SashLi/FreeVarioGauge/Bill_of_Material.xlsx

Sheet: Vario
Value | Part | Part Count | Vendor | Vendor P/N
Vario Board 1
NHD-2.4-240320CF-CSXN#-F |  | 1 | https://www.luna-electronic.de/de/tft-displays/newhaven-display-nhd-2-4-240320cf-csxn-f-2-4-sunlight-readable-tft.html
Espressif ESP32 WLAN Dev Kit Board Development Bluetooth Wifi v1 | US1 | 1 | https://www.ebay.de/itm/Espressif-ESP32-WLAN-Dev-Kit-Board-Development-Bluetooth-Wifi-v1-Deutsche-Post/163771189294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
Precision sockets 2,54 mm, 1X15 |  | 2 | Reichelt | MPE 115-1-015
Pinheader female, 8-pin | SV2 | 1 | Reichelt | RND 205-00653
Pinheader female, 4-pin | JP1 | 1 | Reichelt | RND 205-00651
RJ45 | X1 | 1 | Ebay, Mouser | 215877-1
595-MAX3232-CDWR or 595-MAX3232-IDWR | IC1 | 1 | Reichelt | MAX 3232 CWE
EA WF050-40ST ZIFF conector | X2 | 1 | Reichelt | EA WF050-40ST
SMD chip resistor, 0805, 100 Ohm | R1, R2 | 2 | Reichelt | RND 0805 1 100
SMD chip resistor, 0805, 68 kOhm | R3 | 1 | Reichelt | RND 0805 1 68K
SMD chip resistor, 0805, 33 kOhm | R4 | 1 | Reichelt | RND 0805 1 33K
SMD chip resistor, 0805, 820 Ohm | R5 | 1 | Reichelt | RND 0805 1 820
SMD chip resistor, 0805, 470 Ohm | R6 | 1 | Reichelt | RND 0805 1 470
SMD chip resistor, 0805, 330 Ohm | R7 | 1 | Reichelt | RND 0805 1 330
SMD multilayer ceramic capacitor 10N | C4 | 1 | Reichelt | X7R-G0805 10N
SMD multilayer ceramic capacitor 100N | C1, C2, C3, C5, C8 | 5 | Reichelt | X7R-G0805 100N
SMD multilayer capacitor G0805 - 1,0µF 50V | C9, C11, C14, C17 | 4 | Reichelt | X7R-G0805 1,0/50
SMD multilayer capacitor G0805 - 10µF 16V | C6, C7, C10, C12, C13 | 5 | Reichelt | X5R-G0805 10/16
SMD multilayer ceramic capacitor 220P, 5% | C15, C16 | 2 | Reichelt | NPO-G0805 220P
multilayer ceramic capacitor, 4,7µF, 25V | C18 | 1 | Reichelt | KEM X5R0805 4,7U
transistor, NPN | T1 | 1 | Reichelt | BC 848C SMD
EMI Suppression Filter SMD0603 BLM18 120 Ohm | L1, L2 | 2 | Reichelt | BLM18AG 121
PAM8302A | IC2 | 1
NCP 1117 ST50T3G | Q1 | 1 | Reichelt | NCP 1117 ST50T3G
NCP 1117 ST33T3G | Q2 | 1 | Reichelt | NCP 1117 ST33T3G
Heat sink SMD 6,3 x4,8x 5,0mm | Q1, Q2 | 2 | Reichelt | ICK SMD A5
Self-adhesive thermal foil | Q1, Q2 | 1 | https://www.ebay.de/itm/EC360-ADHESIVE-WHITE-Wärmeleitfolie-kleber-50x50mm-Doppelseitig-3W-mK-WLPad/113931974912?ssPageName=STRK%3AMEBIDX%3AIT
PCB
Vario Board 2
Espressif ESP32 WLAN Dev Kit Board Development Bluetooth Wifi v1 | US1 | 1 | https://www.ebay.de/itm/Espressif-ESP32-WLAN-Dev-Kit-Board-Development-Bluetooth-Wifi-v1-Deutsche-Post/163771189294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
SMD chip resistor, 0805, 10 kOhm | R1, R2, R3, R4, R5 | 5 | Reichelt | SMD-0805 10,0K
TS 4148-1206 Switching diode, 75 V, 150 mA, G1206 | D1 | 1 | Reichelt | TS 4148-1206
SMD multilayer ceramic capacitor 100N | C1 | 1 | Reichelt | X7R-G0805 100N
Pin headers 2.54 mm, 2X05, angled | JP3 | 1 | Reichelt | MPE 088-2-010
Stack bar 2x4 h=26,5mm | X3 | 1
Stack bar 2x2 h=26,5mm | JP1 | 1
Slide switch 1x UM, upright | X4 | 1 | Reichelt | SS ESP101
Precision sockets 2,54 mm, 1x7 | JP2 | 1 | Reichelt | MPE 115-1-007
Precision sockets 2,54 mm, 1X15 | US1 | 2 | Reichelt | MPE 115-1-015
2-pin header, angled | Speaker | 1 | Reichelt | SL 1X36W 2,54
Speaker LSM-S30K/P, 2W, 8Ohm | Speaker | 1 | Reichelt | LSM-S30K/P
JST - socket housing, 1x3-pin - XH | STF-WOELBKLAPPEN | 1 | Reichelt | JST XH3P BU
JST - Stiftleiste, 90°, 1x3-polig - XH | STF-WOELBKLAPPEN | 1 | Reichelt | JST XH3P ST90
JST - crimp contact, socket - XH | STF-WOELBKLAPPEN | 2 | Reichelt | JST XH CKB
PJ-242 - audio jack 2,5mm | X1 | 1 | Aliexpress
PCB
Vario Encoder Board
Potentiometer, 25 kOhm bzw. 22kOhm | R1 | 1 | Reichelt | PIH T16SHM4N253B oder PO4M-LOG 22K
Pinheader female, 10-pin | X1 | 1 | Reichelt | RND 205-00654
JST - socket housing, 1x3-pin - XH | X2 | 1 | Reichelt | JST XH3P BU
JST - pin header, straight, 1x3-pin - XH | X2 | 1 | Reichelt | JST XH3P ST
JST - crimp contact, socket - XH | X2 | 3 | Reichelt | JST XH CKB
Toggle switch 6A-125VAC, 1x On-Off-ON |  | 1 | Reichelt | MS 500C
Encoder | SW1 | 1 |  | PEC11R-4230F-S0012
Banjo bolts (wie z.B. beim Funke ATR833) |  | 2
ROUND KNOB 10, WITHOUT LINE, 4mm Bore hole |  | 2 | https://www.okw.com/ | A2510040 (https://www.okw.com/de/Kombikn%C3%B6pfe/A2510030.htm?var=af9c94b0-c2e5-11e2-8e2c-0050568225d7)
COVER 10, WITHOUT LINE |  | 2 | https://www.okw.com/ | A4110000 (https://www.okw.com/de/Kombikn%C3%B6pfe-Zubeh%C3%B6r/A4110000.htm)
PCB |  | 1

Sheet: BOM-PCB1
Comment | Designator | Footprint | LCSC Part #（optional）
MAX 3232 CWE | IC1 | SO-16 | C143432 (https://lcsc.com/product-detail/RS232-ICs_Maxim-Integrated_MAX3232ECWE_Maxim-Integrated-MAX3232ECWE_C143432.html)
MOLEX 541044031 | X2 | ZIF SMD | C164172 (https://lcsc.com/product-detail/FFC-FPC-Connectors_MOLEX_541044031_MOLEX-541044031_C164172.html)
SMD-Widerstand, 0805, 10 kOhm | R1, R2 | 0805 | C84376
10nF | C4 | 0805 | C83170 (https://lcsc.com/product-detail/Multilayer-Ceramic-Capacitors-MLCC-SMD-SMT_10nF-103-10-50V_C83170.html)
100nF | C1, C2, C3, C5, C8 | 0805 | C49678
1µF | C9, C11, C14 | 0805 | C77083 (https://lcsc.com/product-detail/Multilayer-Ceramic-Capacitors-MLCC-SMD-SMT_muRata_GRM21BR71H105KA12L_1uF-105-10-50V_C77083.html)
10µF | C6, C7, C10, C12, C13 | 0805 | C77075
PAM8302AASCR (https://lcsc.com/product-detail/Audio-Power-OpAmps_Diodes-Incorporated_PAM8302AASCR_Diodes-Incorporated-PAM8302AASCR_C113367.html) | IC2 | MSOP8 | C113367 (https://lcsc.com/product-detail/Audio-Power-OpAmps_Diodes-Incorporated_PAM8302AASCR_Diodes-Incorporated-PAM8302AASCR_C113367.html)
NCP 1117 ST50T3G | Q1 | SOT-223 | C17314 (https://lcsc.com/product-detail/Low-Dropout-Regulators-LDO_ON-Semiconductor-ON-NCP1117ST50T3G_C17314.html)
NCP 1117 ST33T3G | Q2 | SOT-223 | C26537

Sheet: BOM-PCB2
Comment | Designator | Footprint | LCSC Part #（optional）
SMD-Widerstand, 0805, 10 kOhm | R1, R2, R3, R4 | 0805 | C84376
100nF | C1 | 0805 | C49678

Sheet: BOM-PCB3
Comment | Designator | Footprint | LCSC Part #（optional）
SMD-Widerstand, 0805, 10 kOhm | R1, R2, R3, R4 | 0805 | C84376
100nF | C1 | 0805 | C49678
