SashLi/FreeVarioGauge/Housing/body_housing.stl

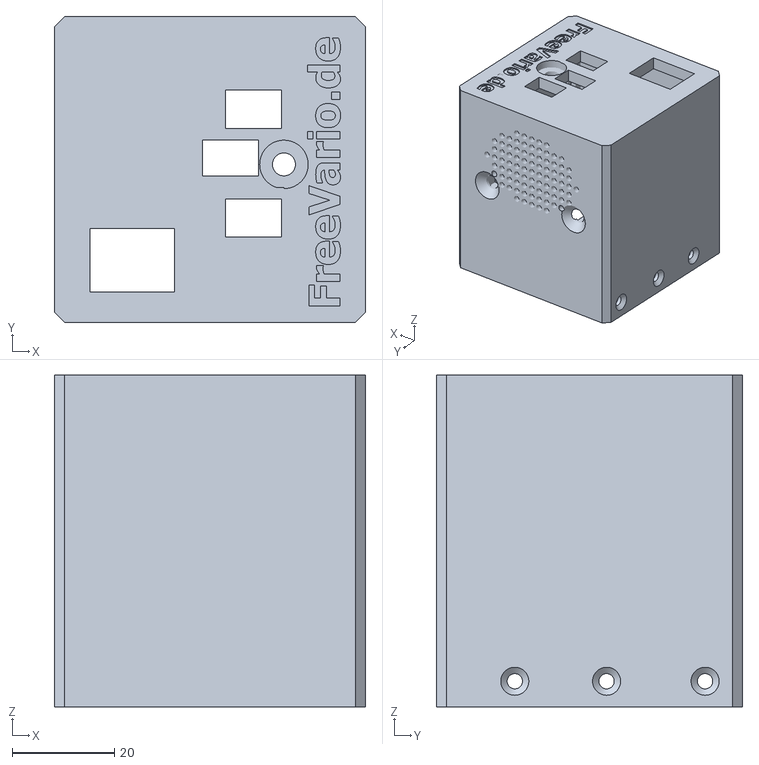
[picture p1: CAD file, 2020-09-28]
Housing/body_housing.stl
61.0 x 60.0 x 65.0
