SashLi/FreeVarioGauge/Housing/MicroUSB.stl

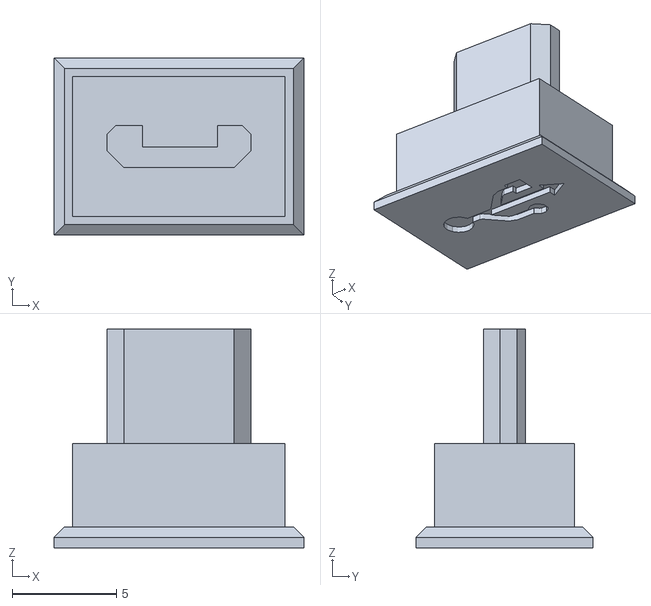
[picture p2: CAD file, 2020-07-25]
Housing/MicroUSB.stl
12.0 x 8.50 x 10.5
