SashLi/FreeVarioGauge/manuals/Instruction_DE.pdf

Copyright Dirk Jung | licensed under CC BY-SA | Page 1

## Anleitung zum Bau und zum Bedienen des FreeVarios

## Inhaltsverzeichnis

V. Installieren von XCSoar inkl. FreeVario-Treiber ohne Neuinstallation des OV-

Ich arbeite auf einem Mac bzw. Linuxsystem. Auf einem Windowsrechner können Kleinigkeiten abweichen!

I. Allgemeines

Das FreeVario wird mit 12V betrieben. Wenn es z.B. mit dem Micro-USB-Stecker nur an 5V angeschlossen wird, funktioniert es grundsätzlich, aber der Audio-Verstärker arbeitet dann nicht fehlerfrei. Er macht dann Geräusche. Das ist also kein Fehler, sondern liegt an der falschen Spannung.
Die Maßgenauigkeit der 3D-gedruckten Teile hängt extrem von den Einstellungen eures Druckers und vom Material ab. Es kann also vorkommen, dass die Teile zu klein sind. Dann müsst ihr die Teile um wenige Prozent größer drucken.
Es scheint hin und wieder unterschiedliche Platinengrößen des ESP32 zu geben. Die Folge ist, dass das Gehäuse nicht richtig schließt. Aus diesem Grunde schneide ich nun immer eine Ecke der Platine ab.


II. Bestücken der Platinen und Zusammenbau des e-Varios

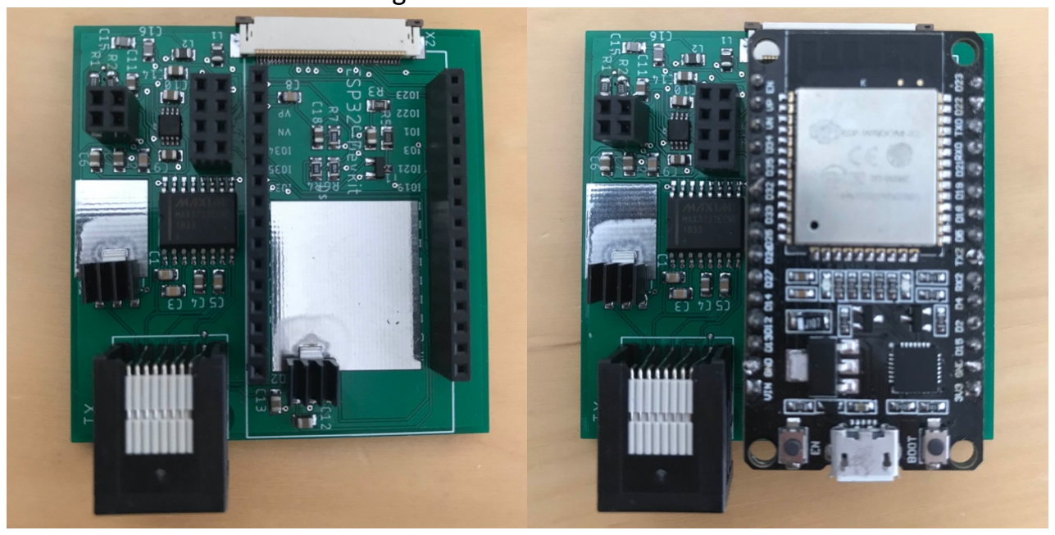
[picture p13: figure]

1. PCB1 sowie auf den Bildern dargestellt zusammenlöten.


2. PCB2 sowie auf den Bildern dargestellt zusammenlöten. Der Abstand der beiden Kunststoffhalterungen der Stapelleiste muss auf 8mm eingestellt werden. Die zu langen Stifte mit einem Seitenschneider auf 22 mm kürzen (siehe 3. Bild).
Mit Hilfe des Schiebeschalters stellt ihr ein, wie das Vario später im Automatikmodus arbeitet. Stellt ihr es auf XCSoar, schickt XCSoar Befehle um zwischen STF und Vario zu wechseln. Stellt ihr es auf Flaps, wird im Automatikmodus durch einen an dem weißen, dreipoligen Stecker angeschlossenen Schalter zwischen STF und Vario umgeschaltet. Dieser Schalter kann z.B. an den Wölbklappen angebracht werden. Wenn das Vario auf STF gestellt werden soll, sollte dieser Schalter geschlossen sein.

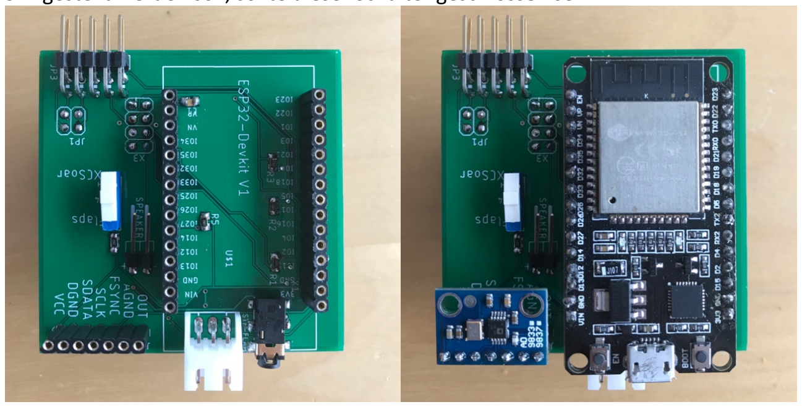
[picture p14: figure]


Die 2,5mm Klinkenbuchse dient zum Anschließen eines externen Lautsprechers. Wird der externe Lautsprecher angeschlossen, wird der interne automatisch abgeschaltet. Beim Löten der Klinkenbuchse müsst ihr sehr vorsichtig sein. Wird zu viel Lötzinn verwendet, funktioniert der Schalter in der Klinkenbuchse anschließend nicht richtig, weil das Lötzinn eindringt, und blockiert. Ich empfehle, die Buchse nach dem Löten wirklich mit und ohne Stecker durchzumessen und ggf. wieder abzulöten und es erneut zu versuchen.

3. Den Drehencoder vorsichtig zerlegen, indem ihr die kleinen Metallbügel aufbiegt. Die Achse des Drehencoders ist mit einem Sicherungsring gesichert. Ihr müsst mit einem Seitenschneider vorsichtig in den Spalt zw. Achse und Gehäuseoberteil gehen und leicht drücken. Wenn die Achse durch den Seitenschneider leicht beschädigt wird, die Stelle wegfeilen. Die Achsen in die Drehmaschine einspannen auf 4mm abdrehen. Anschließend den Drehencoder wieder sorgfältig zusammensetzen und die Metallbügel zurück biegen. Die Achse des Drehencoders wieder mit dem Ring sichern. Kauft euch den Drehencoder sicherheitshalber doppelt, beim ersten Mal geht es ggf. schief. Bohrt die Hohlschrauben auf 4,3mm auf.
4. Am PCB3 an der Position, wo der Encoder sitzt, müsst ihr auf der Seite mit den 3 PINs und oben noch den überstehenden Teil der Platine wegfeilen, sonst passt die Platine nicht spannungsfrei in das Gehäuse. Es kann durchaus sein, dass ihr hier nach dem Löten noch mal ein wenig feilen müsst. Die Kontakte des Potentiometers vorsichtig um 90° nach unten biegen und anlöten. Testet, ob nach der Montage der Frontplatte die Achsen des Encoders und des Potentiometers gut durch die Hohlschrauben passen und sich leicht betätigen lassen. Gegebenenfalls noch mal lösen und etwas verschieben. PCB3 sowie auf den Bildern dargestellt zusammenlöten. Achtet darauf, dass ihr den weißen Stecker so anlötet, dass die PINs auf der rechten Seite sind. Andernfalls passt die Platine später nicht in das Gehäuse. Die Achsen auf eine Länge von 34mm+Dicke des Instumentenbrettes kürzen, gemessen ab Platinenoberseite!

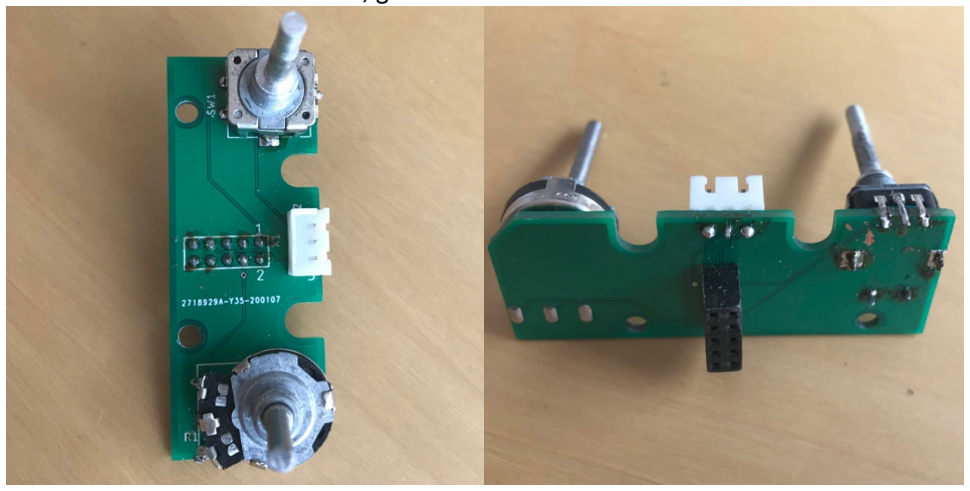
[picture p15: figure]

5. Die drei Gehäuseteile ausdrucken und die Gewinde, wie auf den Bildern markiert, in den Kunststoff schneiden. Rot=M3, Grün=M4, Blau=M6x0,75.
Ich habe sie mit PLA ausgedruckt.

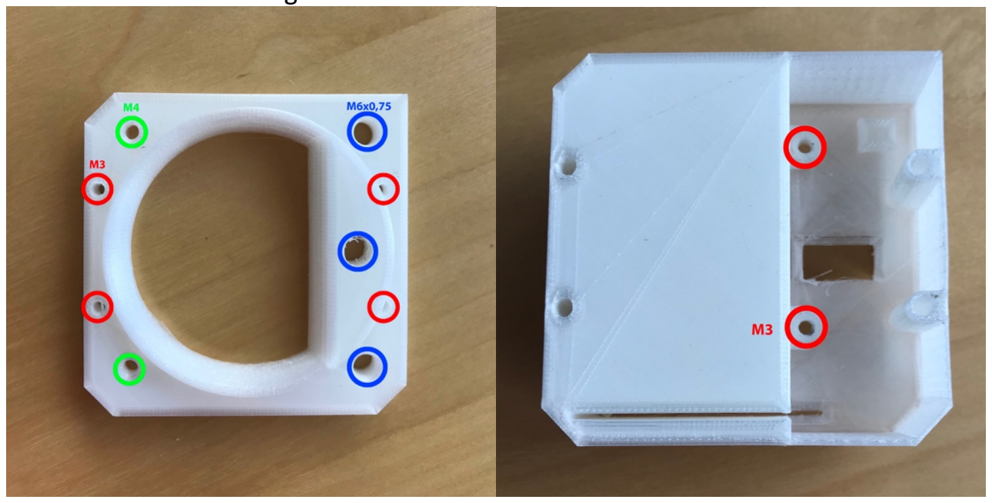
[picture p16: figure]


6. Zwei Gewinde M4 in den Lautsprecher schneiden und Lautsprecher mit 2 Senkkopfschrauben M4x8 im Gehäuse befestigen. Vorher etwa 10cm lange Kabel zum Anschließen des Lautsprechers anlöten. Der Lautsprecher ist nur erforderlich, wenn das FreeVario den Varioton ausgeben soll. Wollt Ihr weiterhin den Varioton von OpenVario nutzen, könnt ihr den Lautsprecher weglassen.
7. Stecker an ein etwa 5cm langes, 3-poliges Kabel krimpen und an den Kippschalter anlöten. Lötet so platzsparend wie möglich, in dem ihr schräg anlötet. Andernfalls gibt es später zwischen den Lötstellen und den dahinterliegenden Kontakten auf dem PCB3 einen Kurzschluss. Macht unbedingt Schrumpfschlauer die Lötkontakte!
Das mittlere Kabel kommt an die mittlere Lötfahne. Je nachdem wie ihr die beiden äußeren Kabel anlötet, habt ihr später STF oder Vario oben. Wenn ihr das obere Kabel des Steckers an die obere Lötfahne des Kippschalters, und das untere Kabel des Steckers an die untere Lötfahne des Kippschalters lötet, ist später Sollfahrt in der unteren Position des Kippschalters, und Vario in der oberen. Automatik ist in der Mitte.
8. Die Gewinde der beiden M4 Befestigungsschrauben auf 3mm + Instumentenbrettdicke kürzen. Arbeitet hier sehr genau, denn wenn die Schrauben zu lang sind, drücken Sie später auf das Display und zerstören es. Am besten ihr schraubt die Frontblende alleine einmal in das Cockpit und checkt, dass die Schrauben nicht in den Bereich des Displays ragen.
9. Kippschalter und das Display in die Frontblende einbauen.
10. PCB3 in das Mittelteil einsetzen und mit 2 Schrauben M3x6 festschrauben. Schrauben mit Gefühl anziehen, die Gewinde sind im Kunststoff!
11. Frontblende und Mittelteil mit 4 Senkkopfschrauben M3x25 zusammenschrauben. Vorher den Kippschalter anklemmen und das FFC-Kabel durch den Schlitz nach hinten führen. Schrauben mit Gefühl anziehen, die Gewinde sind im Kunststoff!

12. Testet nun zu erst, ob sich die beiden Platinen einzeln leicht in den Topf schieben lassen. Andernfalls kann es später zu Beschädigungen kommen. Im Zweifel die Nut etwas nacharbeiten.
13. PCB1 und PCB2 vorsichtig zusammensetzen, Display, Lautsprecher (Plus und Minus nicht vertauschen) und PBC3 anschließen. Den Klemmmechanismus des Displaykabels sehr vorsichtig mit einem kleinen Schraubenzieher oder ähnlichem schließen. Wenn ihr mit den Fingern oder dem falschen Werkzeug abrutscht, kann es leicht passieren, dass euch das Flachbandkabel einreißt.
14. Nun springt ihr am besten zuerst zum Programmieren der beiden ESP32, und macht anschließend hier weiter.
15. Nun den Gehäusetopf vorsichtig über die Platinen schieben. Darauf achten, dass die Platinen in den Schienen sind, und die Western-Digital-Buchse vorsichtig durch die Rückwand führen.
16. Mit 6 Senkkopfschrauben M3x6 die Gehäuseteile verschrauben. Schrauben mit Gefühl anziehen, die Gewinde sind im Kunststoff!
17. Mit den beiden Befestigungsschrauben und den beiden Hohlschrauben das Vario im I-Brett einbauen, die Drehknöpfe montieren und das Vario anschließen. Schrauben mit Gefühl anziehen, die Gewinde sind im Kunststoff!
18. Das Anschlusskabel ist auf beiden Seiten gleich belegt, d.h. gleiche Farbe auf gleichem PIN, so wie ein normales LAN-Kabel.

III. Programmieren der beiden ESP32

1. Legt euch den Ordner Binaries z.B. auf den Desktop.
2. Öffnet ein Terminal oder die Eingabeaufforderung. Dort schaut ihr, ob ihr den Pfad zu Binaries findet. Er lautet bspw. /Users/PC1/Desktop/Binaries/
3. In Arduino IDE auf Arduino -> Einstellungen klicken.
4. Unter „Zusätzliche Boardverwalter-URLs“ die URL hinzufügen. Sind schon URLs eingetragen, mit Komma und Leerzeichen weitere URLs anhängen. https://dl.espressif.com/dl/package_esp32_index.json
5. Hier außerdem unter „Ausführliche Ausgabe während“ „Hochladen“ anklicken.
6. Werkzeuge -> Board -> Boardverwalter klicken und nach ESP32 suchen.
7. „ESP32 by Espressif Systems“ auswählen und installieren.

8. Ihr müsst euch ggf. noch den Treiber für den seriellen Adapter des ESP installieren. https://www.silabs.com/products/development-tools/software/usb-to-uart-bridgevcp-drivers
9. Einen neuen Sketch öffnen und speichern. Merkt euch den Namen. Zum Hochladen folgendes unter Werkzeuge einstellen:
- Board: DOIT ESP32 DEVKIT V1
- Upload Speed: 115200
- Flash Frequency: 80MHz
- Core Debug Level: “Keine”
- Port: Schaue, welche nach dem Anschließen des ESP32 mit dem USB-Kabel neu dazu kommt
10. Dann den leeren Sketch hochladen. Über der Fehlermeldung im Arduino IDE steht in weißer Schrift ein sehr langer Befehl, der in etwa wie folgt lautet: /Users/PC1/Documents/Arduino/hardware/espressif/esp32/tools/esptool/esptool --chip esp32 --port /dev/cu.SLAB_USBtoUART --baud 115200 --before default_reset --after hard_reset write_flash -z --flash_mode dio --flash_freq 80m --flash_size detect 0xe000
/Users/PC1/Documents/Arduino/hardware/espressif/esp32/tools/partitions/boot_ap p0.bin 0x1000
/Users/PC1/Documents/Arduino/hardware/espressif/esp32/tools/sdk/bin/bootloader _dio_80m.bin 0x10000
/var/folders/6t/qjgfw2413f7ddnjzk_08btxw0000gp/T/arduino_build_661147/sketch_ dec30d.ino.bin 0x8000
/var/folders/6t/qjgfw2413f7ddnjzk_08btxw0000gp/T/arduino_build_661147/sketch_ dec30d.ino.partitions.bin
11. Diesen Befehl kopieren, den braucht ihr um die Datei auf den ESP32 zu laden.
12. Der erste Teil des Befehls zeigt euch, wo Arduino IDE sein Arbeitsverzeichnis anlegt. Merkt euch den Ort. In diesem Beispiel wäre das: /Users/PC1/Documents/Arduino
13. Ändert den Befehl mit eurem Ort, an dem der Ordner Binaries liegt, ab. Ändert außerdem die beiden letzten Dateinamen wie folgt ab (siehe Fettdruck).

Display-ESP:
/Users/PC1/Documents/Arduino/hardware/espressif/esp32/tools/esptool/esptool --chip esp32 --port /dev/cu.SLAB_USBtoUART --baud 115200 --before default_reset --after hard_reset write_flash -z --flash_mode dio --flash_freq 80m --flash_size detect 0xe000 /Users/PC1/Desktop/Binaries/boot_app0.bin 0x1000 /Users/PC1/Desktop/Binaries/bootloader_dio_80m.bin 0x10000 /Users/PC1/Desktop/Binaries/FreeVarioGauge.ino.bin 0x8000 /Users/PC1/Desktop/Binaries/FreeVarioGauge.ino.partitions.bin

Sound-ESP:
/Users/PC1/Documents/Arduino/hardware/espressif/esp32/tools/esptool/esptool --chip esp32 --port /dev/cu.SLAB_USBtoUART --baud 115200 --before default_reset --after hard_reset write_flash -z --flash_mode dio --flash_freq 80m --flash_size detect 0xe000 /Users/PC1/Desktop/Binaries/boot_app0.bin 0x1000 /Users/PC1/Desktop/Binaries/bootloader_dio_80m.bin 0x10000 /Users/PC1/Desktop/Binaries/VarioSound.ino.bin 0x8000 /Users/PC1/Desktop/Binaries/VarioSound.ino.partitions.bin
14. Den ESP32 mit dem USB-Kabel am PC anschließen und ein Terminal bzw. die Eingabeaufforderung öffnen. Dort den jeweils passenden Befehl absetzen.
15. Nachdem der Upload abgeschlossen ist, startet der ESP32 neu. Der Sound-ESP32 ist damit fertig. Der Display-ESP32 endet, falls das Display schon angeschlossen ist, mit einem schwarzen Bildschirm. Es müssen noch Dateien in den Speicher dieses ESP32 hochgeladen werden.
16. ESP32 | Sketch | Data | Upload | installieren. | Dazu | ESP32FS-1.0.zip | bei
https://github.com/me-no-dev/arduino-esp32fs-plugin/releases/ herunterladen.
17. Auf dem Mac den entpackten Ordner ESP32FS nach /Programme/Arduino (Paketinhalt anzeigen)/Contents/Java/tools kopieren.
18. Unter Windows den entpackten Ordner ESP32FS nach /Programme/Arduino/tools kopieren.
19. Die Datei data.zip entpacken. Geht in das Arbeitsverzeichnis von Arduino IDE (z.B. /Users/PC1/Documents/Arduino) und dort in den Ordner eures eben angelegten Sketches. Hierher den entpackten Ordner data kopieren.
20. Arduino IDE neu starten, euren neu angelegten Sketch öffnen.
21. WICHTIG!! Darauf achten, dass der serielle Monitor geschlossen ist.
22. Nun unter Werkzeuge „ESP32 Sketch Data Upload“ anklicken.
23. Nach dem der Upload abgeschlossen ist, startet der ESP32 neu und, falls das Display schon angeschlossen ist, seht ihr nun auch die Anzeige des e-Varios.
24. Nun geht zurück zu Punkt 13 des Montageteils der Anleitung.

IV. Installieren des neuen OV-Images inkl. XCSoar mit FreeVario-Treiber

1. Ab dem offiziellen Image 21033 von OpenVario ist der FreeVario-Treiber im Image integriert. Ihr seid also nicht mehr darauf angewiesen, Images von FreeVario.de zu verwenden. Solltet ihr bereits ein Image ab 21033 installiert haben, könnt ihr das FreeVario direkt ohne Änderungen an eurer Software anschließen.
2. Sichern des Ordners .xcsoar vom alten System
- OpenVario booten und ins Menü gehen. Dort „Exit to the shell“ auswählen und mit Yes bestätigen. Euren USB-Stick zum Verwalten des OpenVarios und eine USB-Tastatur anschließen. Gebt folgende Befehle ein.
- mkdir /tmp/USB
- mount /dev/„USB-Stick“ /tmp/USB (/„USB-Stick“ ist i.d.R. /dev/sda1)
- cp -r .xcsoar /tmp/USB (dauert etwas!)
- cd /tmp/USB
- mv .xcsoar xcsoar
- rm -r openvario/upload/xcsoar
- mv xcsoar openvario/upload/
3. Sichern des Wertes zur Kalibrierung der Spannungsanzeige (falls ihr das überhaupt kalibriert habt, ansonsten Schritt überspringen):
- OpenVario booten und ins Menü gehen. Dort „Exit to the shell“ auswählen und mit Yes bestätigen. Schließt eine USB-Tastatur an und gebt folgende Befehle ein.
- nano /opt/conf/sensord.conf
- den Wert bei der Variablen „voltage_config” aufschreiben. Bei mir war das „voltage_config 1592.4 4.54545“.
- 1592.4 ist der Skalierungsfaktor, 4.54545 ist der Offset. Die Formel, um den Wert des AD-Wandlers in die Spannung umzurechnen, lautet:
U = (Wert AD-Wandler / Skalierungsfaktor) + Offset
4. Sichern der WiFi-Einstellungen:
- Kopiert euch den Ordner /var/lib/connman auf den USB-Stick, der ja bereits gemountet ist.
- cp -r /var/lib/connman /tmp/USB
5. Installieren des neuen Images:

Variante 1: Neue SD-Karte verwenden (sichere Methode)
- Mit einem Linux-PC das neue Image auf eine andere SD-Karte schreiben. So könnt Ihr sicher sein, dass auf der alten Karte noch ein funktionierendes System ist, falls etwas schief geht.
- das Image zuerst entpacken:
- gunzip “Pfad_zum_Image“
- z.B.: gunzip /home/USER/Schreibtisch/OpenVario-linux-openvario-image-testingglibc-ipk-20149-openvario-7-PQ070.rootfs.img.gz
- dd if=“Pfad_zum_Image“ of=/dev/„neue_SD-Karte“
- z.B.: dd if=OpenVario_neu.img of=/dev/sda

Variante 2: Alte SD-Karte überschreiben (unsichere Methode)
- In das Hauptverzeichnis des USB-Sticks „openvario“ legt ihr die recovery-Datei „ov-recovery.itb“, die ihr auf dem FTP-Server (ftp://ftp.openvario.org/recovery) herunterladen könnt.

- WICHTIG!! Wenn ihr keine Wiederherstellung durchführen wollt, muss die Datei „ov-recovery.itb“ unbedingt umbenannt werden, z.B. in „ov-recovery.xxx“.
- Kopiert das zu installierende Image als .gz-Datei auf den USB-Stick in den Unterordner images
- Steckt den USB-Stick in das OpenVario und bootet.
- Das Wiederherstellungsmenü wird in Rot dargestellt. Denkt daran, dass beim Ausführen der Wiederherstellung alle Dateien im OpenVario gelöscht werden!
- Wählt „Write image to SD Card“ und anschließend „Update complete SD Card“ aus
6. Die neue SD-Karte in das OpenVario einsetzen, und starten. Dann wieder in das Menü von OpenVario gehen.
- „Copy file to and from OpenVario” -> „Upload files from USB to XCSoar” anklicken. Damit werden alle eure Einstellungen wiederhergestellt. Warten bis „Done!!“ Angezeigt wird.
- Anschließend unter „Update, Settings, …” -> „System Settings” mit „Set rotation of the display” die gewünschte Ausrichtung des Displays einstellen.
- Ggf. unter „Update, Settings, …” „Calibrate Touch” auswählen.
- unter „Update, Settings, …” „Calibrate Sensors” auswählen.
- Zuletzt noch unter „Update, Settings, …” -> „System Settings” -> „Set language used for XCSoar” die Sprache einstellen.
- Mit ESC zurück ins Hauptmenü und „Restart“ auswählen und mit Yes bestätigen.
7. Kalibrierung der Spannungsanzeige wiederherstellen:
- nano /opt/conf/sensord.conf
- „voltage_config” wieder auf die notierten Werte setzen
8. Sicherung alter WiFi-Einstellungen wiederherstellen:
- Den auf dem USB-Stick gesicherten Ordner connman wieder in das Verzeichnis /var/lib kopieren
- mkdir /tmp/USB
- mount /dev/„USB-Stick“ /tmp/USB (/„USB-Stick“ ist i.d.R. /dev/sda1)
- cp -r /tmp/USB/connman /var/lib
9. WiFi wieder einrichten, wenn keine Sicherung der alten Einstellungen besteht:
- OpenVario booten und ins Menü gehen. Dort „Exit to the shell“ auswählen und mit Yes bestätigen. Schließt eine USB-Tastatur an und gebt folgende Befehle ein.
- connmanctl
- enable wifi
- scan wifi
- services
- agent on
- connect wifi_...
- Passwort eingeben

V. Installieren von XCSoar inkl. FreeVario-Treiber ohne Neuinstallation des OV-Images
1. Wenn ihr nicht dass komplette Image von OV neu installieren wollt, sondern nur die Version von XCSoar austauschen wollt, dann könnt ihr das wie unten beschrieben tun. Dabei bleiben eure Einstellungen in XCSoar komplett erhalten. Eine Sicherungsdatei der SD-Karte würde ich mir aber immer vorher anlegen. Schief gehen kann immer mal was!
2. Die neue Version der Installationsdatei von XCSoar auf einen USB-Stick kopieren, im Menü von OpenVario „Exit to the shell“ auswählen. Dort mit fdisk -l den Pfad des USB-Stick finden (z.B. /dev/sda1).
3. mkdir /tmp/USB
4. mount /dev/sda1 /tmp/USB
5. cd /tmp/USB
6. opkg remove xcsoar
7. opkg install xcsoar*.ipk
8. Im Menü von OpenVario noch mal die Sprache neu einstellen, und einen Reboot machen.

VI. Abschalten des Variotons vom OpenVario

### 1. Überspringt diesen Abschnitt komplett, wenn ihr den Varioton von OpenVario

weiter nutzen wollt. Wollte ihr das FreeVario den Ton ausgeben lasen, müsst ihr diesen Abschnitt durcharbeiten.

2. Geht über das OpenVario Menü auf „Exit to the shell“ und gebt dort den Befehl „systemctl disable variod“ ein, um den Varioton von OpenVario abzuschalten.
3. Das OpenVario neu starten.
4. Ändert den Port des NMEA-Anschlusses A von 4352 auf 4353.
5. Sollte weiterhin in XCSoar ein Varioton zu hören sein, wird dieser vom XCSoar erzeugt.
6. Unter System -> Anzeige -> Audio-Vario Audio-Vario auf Aus stellen. Mit Schließen bestätigen.

VII. Einstellungen Doppelsitzer

1. Um das vordere und hintere OpenVario miteinander zu verbinden, müsst ihr ein gekreuztes Kabel verwenden. Das heißt, ihr müsst die PINs 5 un6 für RX und TX an einem Stecker vertauschen.
2. Das vordere Gerät wird auf die zu verwendende RJ45-Buchse eingestellt, z.B. ttyS3, als Treiber wird NMEA output eingestellt, die Baudrate z.B. auf 38400 (sie muss vorne und hinten gleich sein!)
3. Das hintere Gerät wird ebenfalls auf die zu verwendende RJ45-Buchse eingestellt, z.B. ttyS3, als Treiber wird OpenVario eingestellt, und die Baudrate ist gleich mit dem vorderen Gerät einzustellen.

VIII. Sperren des Standardprofils für den Vereinseinsatz

1. Geht im Hauptmenü des OpenVario in die Konsole, in dem ihr „Exit to Shell“ auswählt.
2. Geht mit „cd .xcsoar“ in das Verzeichnis, in dem die Profile abgelegt werden.
3. Standardmäßig heißt das Profil openvario.prf. Ich habe es in clubprofile.prf umbenannt (mv openvario.prf clubprofile.prf)
4. Mit folgendem Befehl das Profil sperren:
chattr +i clubprofile.prf
5. Mit folgendem Befehl das Profil entsperren: chattr -i clubprofile.prf

IX. Einstellungen in XCSoar

1. Unter Konfig. -> NMEA-Anschluss einen freien Anschluss aus A, B, C oder D auswählen und auf Bearbeiten klicken.
2. Bei Anschluss wählt ihr den Anschluss, an dem das e-Vario angeschlossen wurde (z.B. ttyS1).
3. Baudrate ist 115200, Treiber ist FreeVario, mit OK und Schließen bestätigen.

X. Installation des neuen OpenVario Menüs von Kedder
1. Das OpenVario muss mit dem Internet verbunden und es muss einen Tastatur angeschlossen sein.
2. Startet OpenVario und geht in das OV-Menü. Dort „Exit to the shell“ auswählen und mit Yes bestätigen.
3. Gebt dort folgende Befehle ein:
- echo src/gz kedder_core http://openvario.lebedev.lt/opkg/armv7vet2hf-neon/ >> /etc/opkg/customfeeds.conf
- echo src/gz kedder_all http://openvario.lebedev.lt/opkg/all/ >> /etc/opkg/customfeeds.conf
- opkg update
- opkg install openvario-shell openvario-shell-autostart --force-removal-of-dependent-packages
4. Mit ESC zurück ins Hauptmenü und „Restart“ auswählen und mit Yes bestätigen. Das neue Menü wird ab jetzt verwendet.

XI. Bedienung des FreeVarios

1. Mit Hilfe des Kippschalters wird das Vario auf SpeedToFly (STF) oder Vario-Modus (Vario) umgeschaltet. In der Mittelstellung ist der Automatikmodus aktiv. Je nach Stellung des Schiebeschalters im Gerät auf der oberen Platine bestimmt XCSoar oder ein extern angebrachter Schalter im Automatikmodus, ob Vario oder STF aktiv sein soll. Der externe Schalter kann beispielsweise mit den Wölbklappen verbunden werden, so dass je nach Klappenstellung automatisch zwischen Vario und STF umgeschaltet wird. Wenn das Vario auf STF gestellt werden soll, sollte dieser Schalter geschlossen sein. Alternativ könnte auch ein Kippschalter am Knüppel verwendet werden, wenn der Kippschalter im FreeVario nicht benutzt werden soll. Den Kippschalter im FreeVario dann am besten nicht einbauen.
2. Ist der Modus STF aktiv, geben die Ziffern am farbigen Bogen mit 10 multipliziert die Differenz zwischen true Airspeed und Sollfahrt an.
z.B.: Im Modus STF steht der farbige Balken bei +3. Damit ist die true Airspeed um 30km/h höher als die Sollfahrt.
3. Mit dem Drehencoder oben wird im Normalmodus der McCready-Wert eingestellt und an XCSoar gesendet.
4. Wird der Pushbutton des Drehencoders für mehr als 0,5s gedrückt, wird das Menü aktiviert, und die Zeile, in der die Höhe angezeigt wird, wird rot. Durch Drehen am Encoder kann die Zeile mit der Geschwindigkeitsanzeige oder mit dem McCready-Wert ausgewählt werden. Durch ein kurzes Drücken des Pushbuttons wird der ausgewählte Menüpunkt aktiviert. Im Hohenmenü kann nun durch Drehen zwischen Höhe über NN (MSL) und Höhe über Grund (AGL), im Geschwindigkeitsmenü kann zwischen Groundspeed (GS) und true Airspeed (TAS) ausgewählt werden. Ein weiteres kurzes Drücken des Pushbuttons wählt die aktuelle Einstellung aus und im Display werden die gewünschten Werte angezeigt.

5. Eine Besonderheit stellt die untere Anzeige für den McCready dar. Hier kann bei aktiviertem Menü durch Drehen zwischen QNH, Bug und Mute ausgewählt werden. Ein kurzes Drücken des Pushbuttons aktiviert die gewünschte Option, und durch Drehen am Encoder wird der Wert eingestellt und an XCSoar gesendet. Ein weiteres kurzes Drücken des Pushbuttons schließt den Menüpunkt und im Display wird wieder der McCready-Wert angezeigt.
6. Wird das Menü für mindestens 10s nicht benutzt, wird das Menü automatisch wieder verlassen, und die zu diesem Zeitpunkt ausgewählte Einstellung übernommen.
7. Die 2,5mm Klinkenbuchse auf der Rückseite dient zum Anschließen eines externen Lautsprechers, um einen besseren Sound zu erhalten. Ist der externe Lautsprecher angeschlossen, wird der interne automatisch deaktiviert.
8. Wenn der PIN „a“ des dreipoligen Steckers mit der Sendetaste verbunden wird, wird der Variosound beim Funken automatisch stumm geschaltet. Falls das Funkgerät und das FreeVario an unterschiedlichen Batterien angeschlossen sind, muss der Minuspol beider Batterien miteinander verbunden werden! Wird das Funkgerät z.B. zum Sparen von Strom ausgeschaltet, ist das für das FreeVario das gleiche, als würden man die Sendetaste drücken. Damit das FreeVario aber weiterhin den Varioton ausgibt, gibt es im untersten Menüpunkt die Option Mute. Sie kann auf ON bzw. OFF gestellt werden. Schaltet man sie auf OFF, ist die Funktion deaktiviert. Bei einem Neustart des FeeVarios ist sie automatisch wieder aktiv.

XII. Installation

1. Micro-USB-Anschluss zum updaten des Soundbords
2. 2,5mm Klinkenbuchse für externen Lautsprecher
3. Stecker für Sollfahrtschalter/Wölbklappenschalter und PTT-Taste
a. PTT
b. Sollfahrt-Schalter
c. Sollfahrt-Schalter
4. Micro-USB-Anschluss zum updaten des Displaybords
5. IGC-Stecker für OpenVario


1. Die beiden Hohlschrauben über die Achse des Encoders bzw. Potentiometers schieben und mit dem FreeVario verschrauben
2. Die beiden M4 Schrauben unbedingt vor der Montage kürzen (3mm + Instumentenbrettdicke) und auf richtige Länge prüfen, da ansonsten das Display zerstört wird!

3. Das FreeVario mit den Schrauben M4 befestigen
4. Die beiden Drehknöpfe festschrauben. Darauf achten, dass der Encoderknopf genug Platz nach hinten hat, damit der Pushbutton funktioniert
5. Abdeckkappen auf Drehknöpfe anbringen
6. FreeVario an OpenVario mit einem IGC-konformen Kabel anschließen
7. An dem drei-poligen Stecker ggf. Wölbklappenschalter (geschlossen, wenn auf STF gestellt werden soll) und PTT-Taste anschließen

XIII. Ausschlusserklärung

Das e-Vario ist nicht EASA- oder FAA-zertifiziert. Dies gilt im Übrigen für viele kommerzielle e-Varios und Flugcomputer, die ihr wahrscheinlich gewohnt seid.

Wenn ihr wissen möchtet, ob ihr dieses e-Vario in eurem Segelflugzeug legal verwenden dürft, wendet euch an euren Prüfer. Könnt ihr legal einen anderen (auch nicht zertifizierten) Flugcomputer anderer Hersteller installieren? Wenn ja, solltet ihr auch dieses e-Vario legal installieren dürfen. Wenn euer Flugzeug unter die EASA-Regeln fällt, lest CS-STAN, Standardänderung CS-SC402a.

Es handelt sich bei diesem Instrument um ein Bastelprojekt und nicht um ein luftfahrtzugelassenes Instrument. Ich weise ausdrücklich darauf hin, dass der Einsatz unter Ausschluss jeglicher Gewährleistung auf eigenes Risiko erfolgt!
