SashLi/FreeVarioGauge/(commit log)

2020-05-19 Change menu frame
    instead of a menu frame that is blinking to select the menu, color of sprite text is red. Frame color is red instead of white
2020-05-22 Revert "Change menu frame"
    This reverts commit 64726d68afe30677866c986bb191b4c65f14ab7c.
    [FreeVarioGauge.ino]
2020-05-22 Revert "Revert "Change menu frame""
    This reverts commit 0f92ed3b02f36ffc2c4f9b9ce3ad9d3c444aaec3.
    [FreeVarioGauge.ino]
2020-05-22 Revert "Revert "Revert "Change menu frame"""
    This reverts commit 1ac43deba0b08b3dde1e44f4ed29fe3aea03ce9d.
    [FreeVarioGauge.ino]
2020-05-22 Revert "Revert "Revert "Revert "Change menu frame""""
    This reverts commit 8c656cb06632aad2aa92f6a5aa9281f37eafeb41.
    [FreeVarioGauge.ino]
2020-05-23 better performance for menu frame
2020-05-23 Change encoder turn direction
2020-06-02 Uploaded housing and gerber files
    [Frontblende.stl, Gehaeusetopf.stl, MicroUSBStecker.stl, Mittelteil.stl]
2020-06-02 Change names
    [MicroUSB.stl, body_housing.stl, front_panel.stl, middle_section.stl]
2020-06-02 rename files
    [MicroUSB.stl, body_housing.stl, front_panel.stl, middle_section.stl]
2020-06-02 Uploaded BOM file
    [Bill_of_Material.xlsx]
2020-06-03 corrected errors at gerber files
2020-06-06 removed errors
    [Bill_of_Material.xlsx, body_housing.stl]
2020-06-11 updated PCBs
2020-06-20 updated PCB1
    [Bill_of_Material.xlsx]
2020-06-22 incuding a pre-amplifier
    [Bill_of_Material.xlsx]
2020-06-24 Translate Bill of Material
    [Bill_of_Material.xlsx]
2020-07-06 update housing and middle section
    [body_housing.stl, middle_section.stl]
2020-07-21 updated housing
    [body_housing.stl, middle_section.stl]
2020-09-14 Housing with mono jack
    [body_housing.stl]
2020-09-17 include PTT
    mute when PTT is pressed
    [Bill_of_Material.xlsx]
2020-09-28 Updates because of mute with PTT
    [Bill_of_Material.xlsx, body_housing.stl]
2020-10-21 Mute via PTT
    corrected errors of mute function. Mute via PTT dosen't work with V1.1!
    [Bill_of_Material.xlsx]
2021-01-03 driver patch for XCSoar
2021-03-05 New images with new sensord
2021-12-07 Bug at QNH value
    Bug: QNH value from XCSoar was shown as "0000".
    [FreeVarioGauge.ino]
2021-12-27 updated Patch file and current converter PCB1
2022-01-05 Remote Stick can control FreeVario
    [Bill_of_Material.xlsx]
2022-01-08 Fix a bug at stick remote control
    [VarioSound.ino]
2022-01-28 updates for tag 1.1.4
    [Bill_of_Material.xlsx]
2022-04-04 including i2cdetect and chattr to the images
2022-07-09 fixed errors with damping
    [FreeVarioGauge.ino, VarioSound.ino]
2022-07-09 sends QNH again after OpenVario has rebooted
    [FreeVarioGauge.ino]
2022-07-16 repository is moved
    [Bill_of_Material.xlsx, MicroUSB.stl, body_housing.stl, front_panel.stl, middle_section.stl]
